tickelton/XC9572XL_development_board/images/XC9572XL_dev_board_pinout.jpg

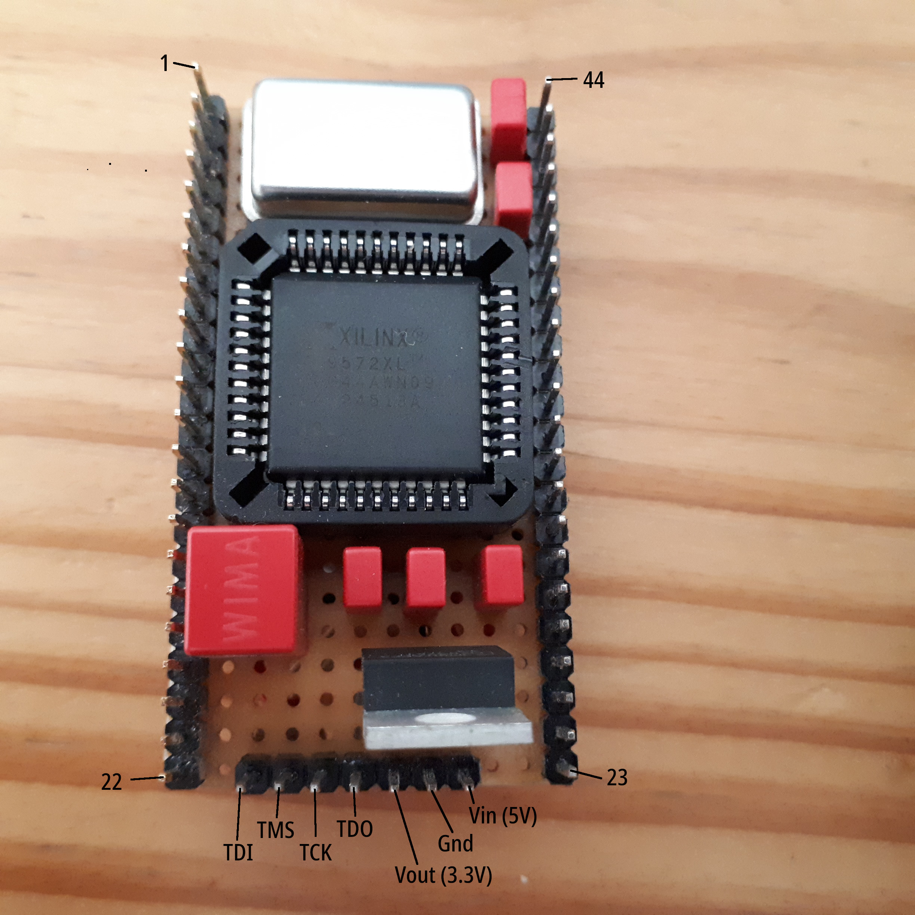
images/XC9572XL_dev_board_pinout.jpg
