tickelton/XC9572XL_development_board/hardware/XC9500XL_development_board.pdf

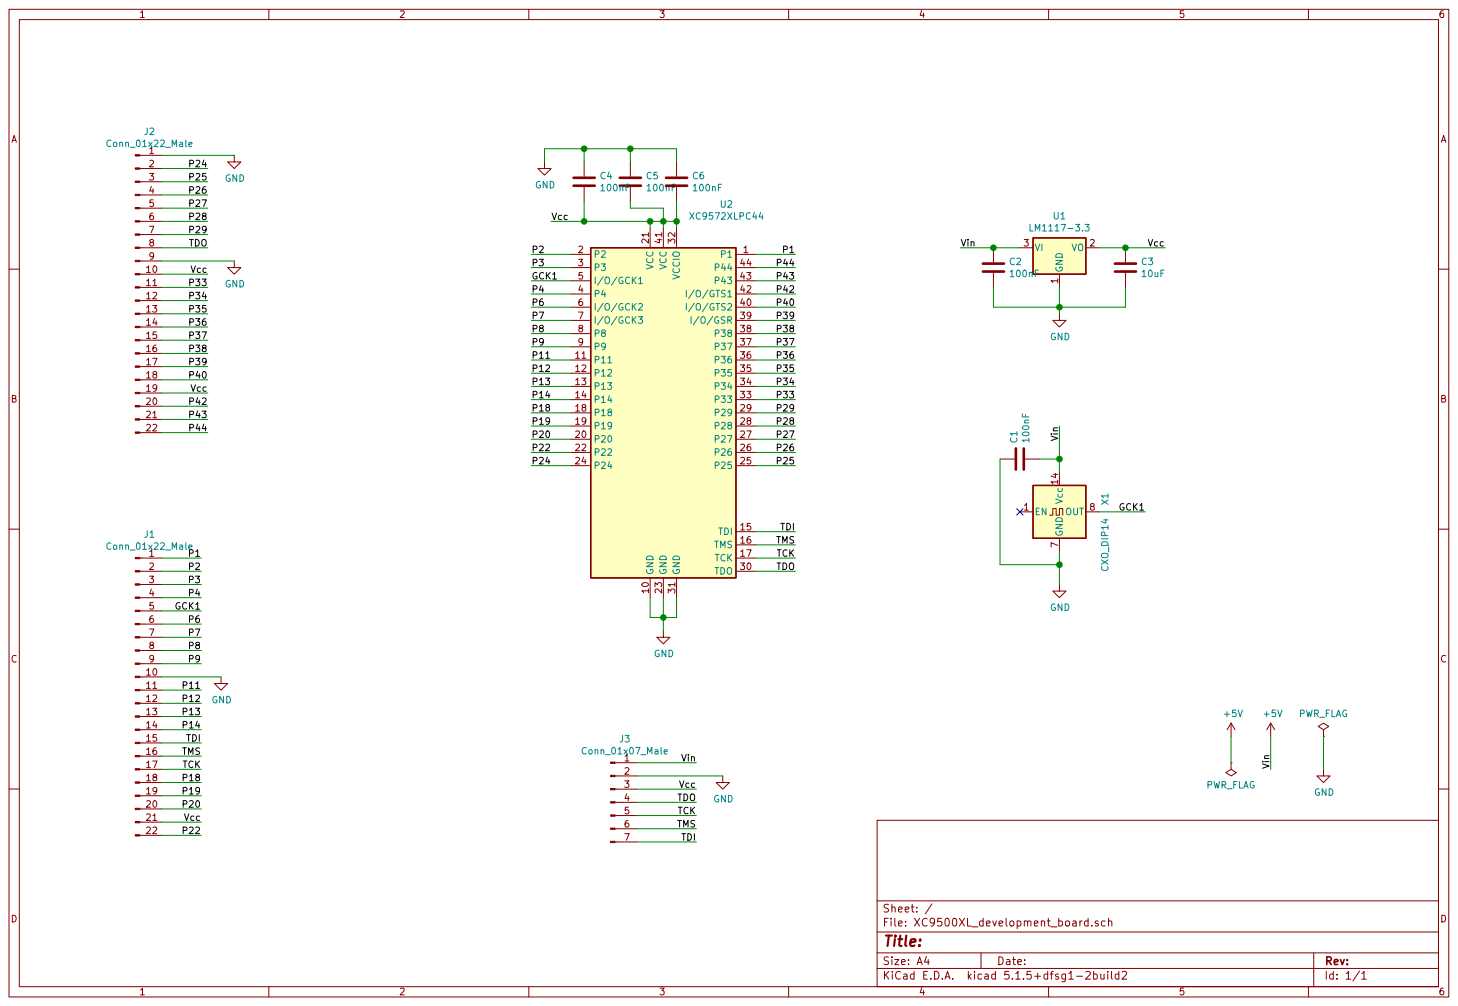
[picture p2: page 1]
