tickelton/XC9572XL_development_board/(commit log)

2020-09-29 Adds missing capacitor values
    [XC9500XL_development_board.sch]
2020-09-29 Adds image of finished board
2020-10-02 Adds instructions on programming via JTAG
    [xc9500xl.cfg]
2021-02-28 Adds LED blinking demo programs
